maddoxlab/spdif-splitter/README.md

# spdif-splitter
Design files and code for S/Plitter, a box that turns optical S/PDIF signals into separate TTL bits for EEG triggering in auditory experiments
