maddoxlab/spdif-splitter/bp2bs_adapter/adapter/adapter.kicad_pcb

## KiCad design bp2bs_adapter/adapter/adapter.kicad_pcb (2021-09-14)

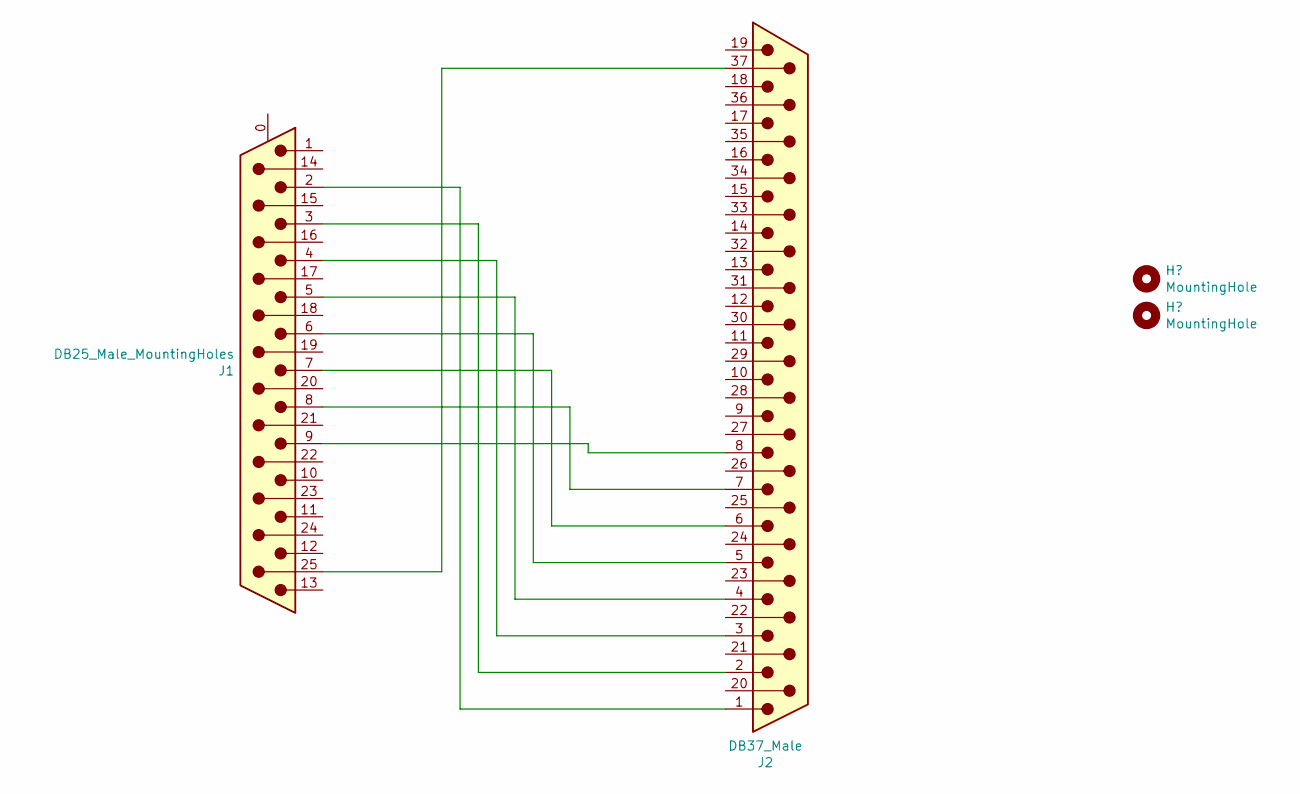
[picture p1: schematic adapter.sch]

Parts:
J1: DB25_Male_MountingHoles; DSUB-25_Male_Horizontal_P2.77x2.84mm_EdgePinOffset4.94mm_Ho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
J2: DB37_Male; DSUB-37_Male_Horizontal_P2.77x2.84mm_EdgePinOffset7.70mm_Ho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

Connections:
unnamed: J1.2, J2.1
unnamed: J1.3, J2.2
unnamed: J1.4, J2.3
unnamed: J1.5, J2.4
unnamed: J1.6, J2.5
unnamed: J1.7, J2.6
unnamed: J1.8, J2.7
unnamed: J1.9, J2.8
unnamed: J1.25, J2.37

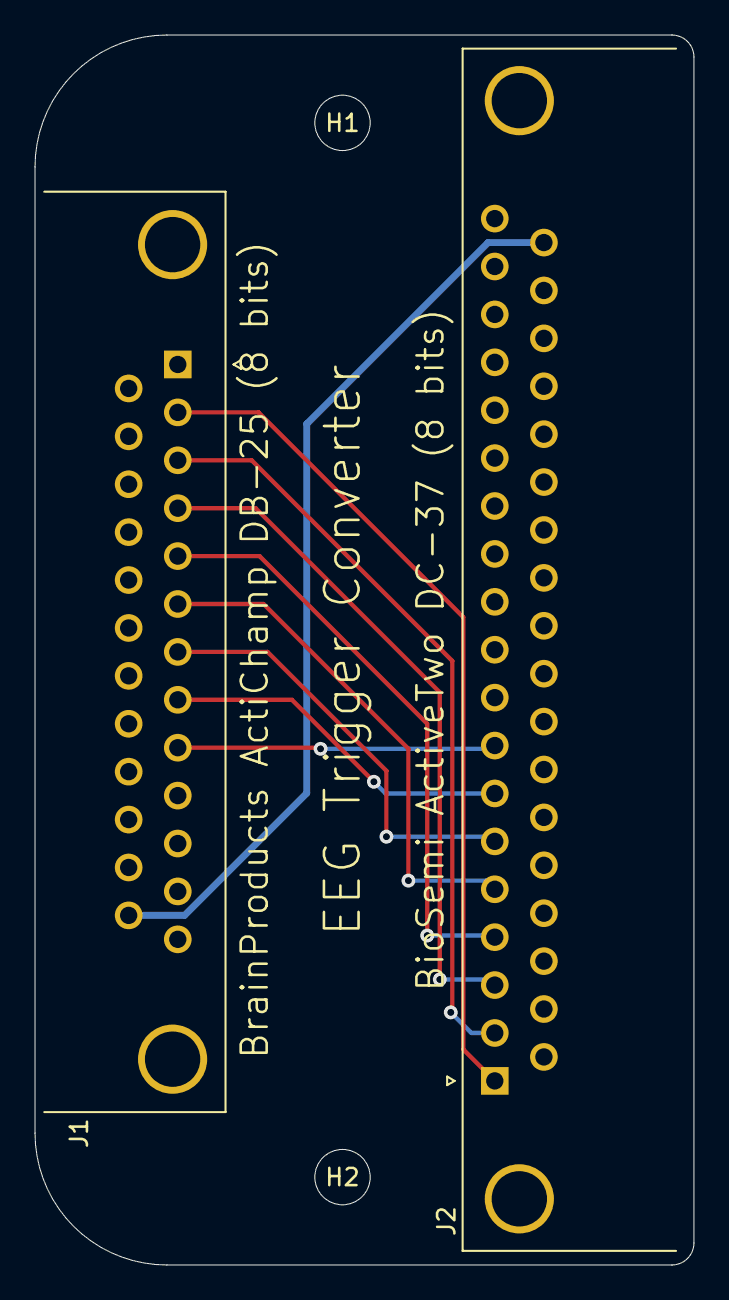
[picture p2: board adapter.kicad_pcb from above]

Board: 2 copper layers, 38.1 x 71.1 mm, 4 parts (0 on the bottom side), 9 nets.

Other parts of the board:
H1, H2: MountingHole; MountingHole_3.2mm_M3
