maddoxlab/spdif-splitter/v2/kicad/spdif-decoder/spdif-decoder.kicad_pcb

## KiCad design v2/kicad/spdif-decoder/spdif-decoder.kicad_pcb (2021-08-18)

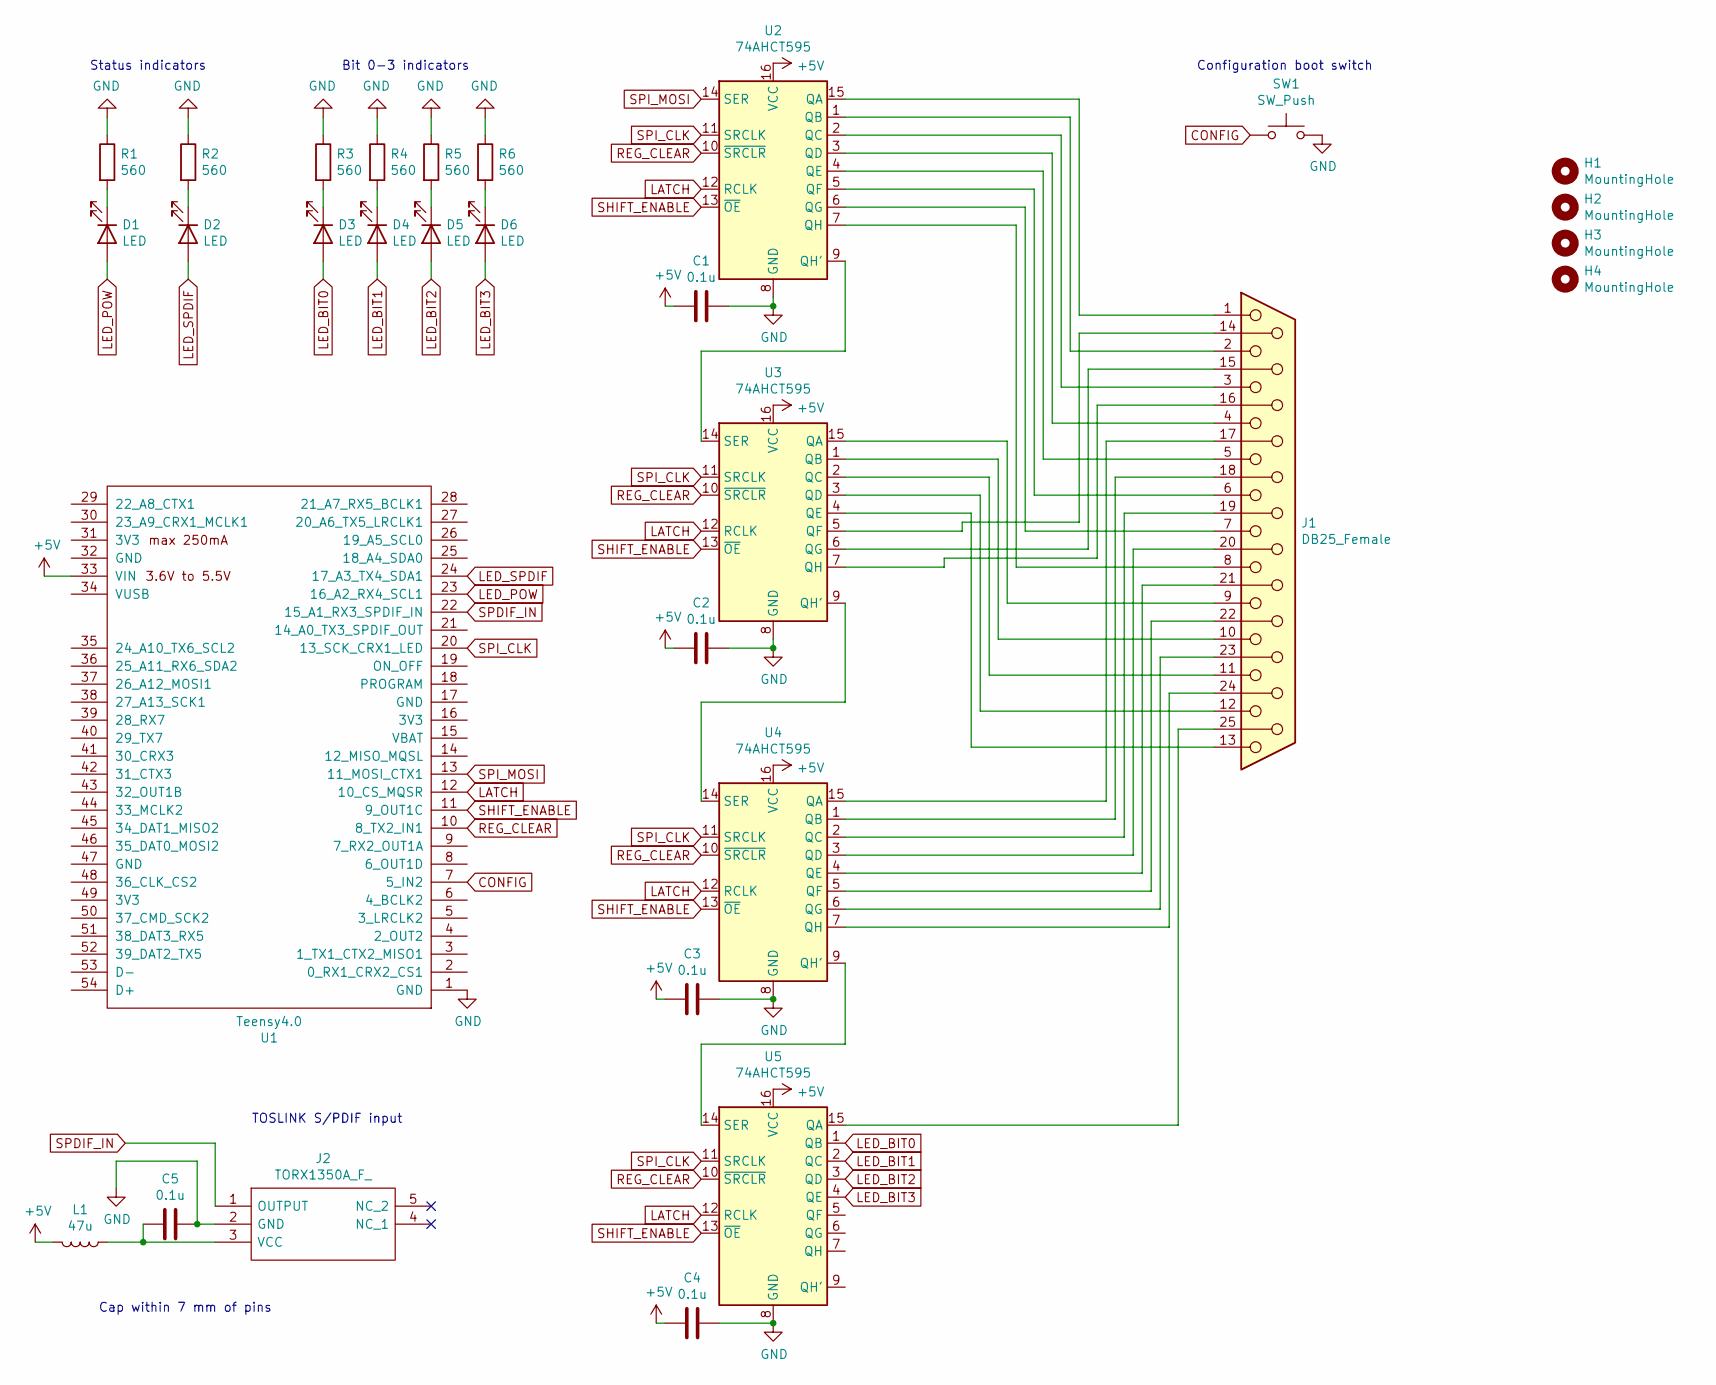
[picture p3: schematic spdif-decoder.sch]

Parts:
C1, C2, C3, C4, C5: 0.1u; C_Disc_D3.0mm_W2.0mm_P2.50mm
D1, D2, D3, D4, D5, D6: LED; LED_D3.0mm
H1, H2, H3, H4: MountingHole; MountingHole_3.2mm_M3
J1: DB25_Female; DSUB-25_Female_Horizontal_P2.77x2.84mm_EdgePinOffset9.90mm_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
J2: TORX1350A_F_; TORX1350AF; Mouser Part Number 757-TORX1350AF
L1: 47u; L_Axial_L5.3mm_D2.2mm_P2.54mm_Vertical_Vishay_IM-1
R1, R2, R3, R4, R5, R6: 560; R_Axial_DIN0207_L6.3mm_D2.5mm_P7.62mm_Horizontal
SW1: SW_Push; SW_PUSH_6mm
U1: Teensy4.0; Teensy40
U2, U3, U4, U5: 74AHCT595; DIP-16_W7.62mm

Connections:
+5V: C1.2, C2.2, C3.2, C4.2, L1.2, U1.33 (VIN), U2.16 (VCC), U3.16 (VCC), U4.16 (VCC), U5.16 (VCC)
CONFIG: SW1.1, U1.7 (5_IN2)
GND: C1.1, C2.1, C3.1, C4.1, C5.1, J2.2 (GND), R1.1, R2.1, R3.1, R4.1, R5.1, R6.1, SW1.2, U1.1 (GND), U2.8 (GND), U3.8 (GND), U4.8 (GND), U5.8 (GND)
LATCH: U1.12 (10_CS_MQSR), U2.12 (RCLK), U3.12 (RCLK), U4.12 (RCLK), U5.12 (RCLK)
LED_BIT0: D3.2 (A), U5.1 (QB)
LED_BIT1: D4.2 (A), U5.2 (QC)
LED_BIT2: D5.2 (A), U5.3 (QD)
LED_BIT3: D6.2 (A), U5.4 (QE)
LED_POW: D1.2 (A), U1.23 (16_A2_RX4_SCL1)
LED_SPDIF: D2.2 (A), U1.24 (17_A3_TX4_SDA1)
unnamed: C5.2, J2.3 (VCC), L1.1
unnamed: D1.1 (K), R1.2
unnamed: D2.1 (K), R2.2
unnamed: D3.1 (K), R3.2
unnamed: D4.1 (K), R4.2
unnamed: D5.1 (K), R5.2
unnamed: D6.1 (K), R6.2
unnamed: J1.1, U2.15 (QA)
unnamed: J1.2, U2.1 (QB)
unnamed: J1.3, U2.2 (QC)
unnamed: J1.4, U2.3 (QD)
unnamed: J1.5, U2.4 (QE)
unnamed: J1.6, U2.5 (QF)
unnamed: J1.7, U2.6 (QG)
unnamed: J1.8, U2.7 (QH)
unnamed: J1.9, U3.15 (QA)
unnamed: J1.10, U3.1 (QB)
unnamed: J1.11, U3.2 (QC)
unnamed: J1.12, U3.3 (QD)
unnamed: J1.13, U3.4 (QE)
unnamed: J1.14, U3.5 (QF)
unnamed: J1.15, U3.6 (QG)
unnamed: J1.16, U3.7 (QH)
unnamed: J1.17, U4.15 (QA)
unnamed: J1.18, U4.1 (QB)
unnamed: J1.19, U4.2 (QC)
unnamed: J1.20, U4.3 (QD)
unnamed: J1.21, U4.4 (QE)
unnamed: J1.22, U4.5 (QF)
unnamed: J1.23, U4.6 (QG)
unnamed: J1.24, U4.7 (QH)
unnamed: J1.25, U5.15 (QA)
unnamed: U2.9 (QH'), U3.14 (SER)
unnamed: U3.9 (QH'), U4.14 (SER)
unnamed: U4.9 (QH'), U5.14 (SER)
REG_CLEAR: U1.10 (8_TX2_IN1), U2.10 (~SRCLR), U3.10 (~SRCLR), U4.10 (~SRCLR), U5.10 (~SRCLR)
SHIFT_ENABLE: U1.11 (9_OUT1C), U2.13 (~OE), U3.13 (~OE), U4.13 (~OE), U5.13 (~OE)
SPDIF_IN: J2.1 (OUTPUT), U1.22 (15_A1_RX3_SPDIF_IN)
SPI_CLK: U1.20 (13_SCK_CRX1_LED), U2.11 (SRCLK), U3.11 (SRCLK), U4.11 (SRCLK), U5.11 (SRCLK)
SPI_MOSI: U1.13 (11_MOSI_CTX1), U2.14 (SER)

Notes on the sheet:
Bit 0-3 indicators
Status indicators
TOSLINK S/PDIF input
Cap within 7 mm of pins
Configuration boot switch

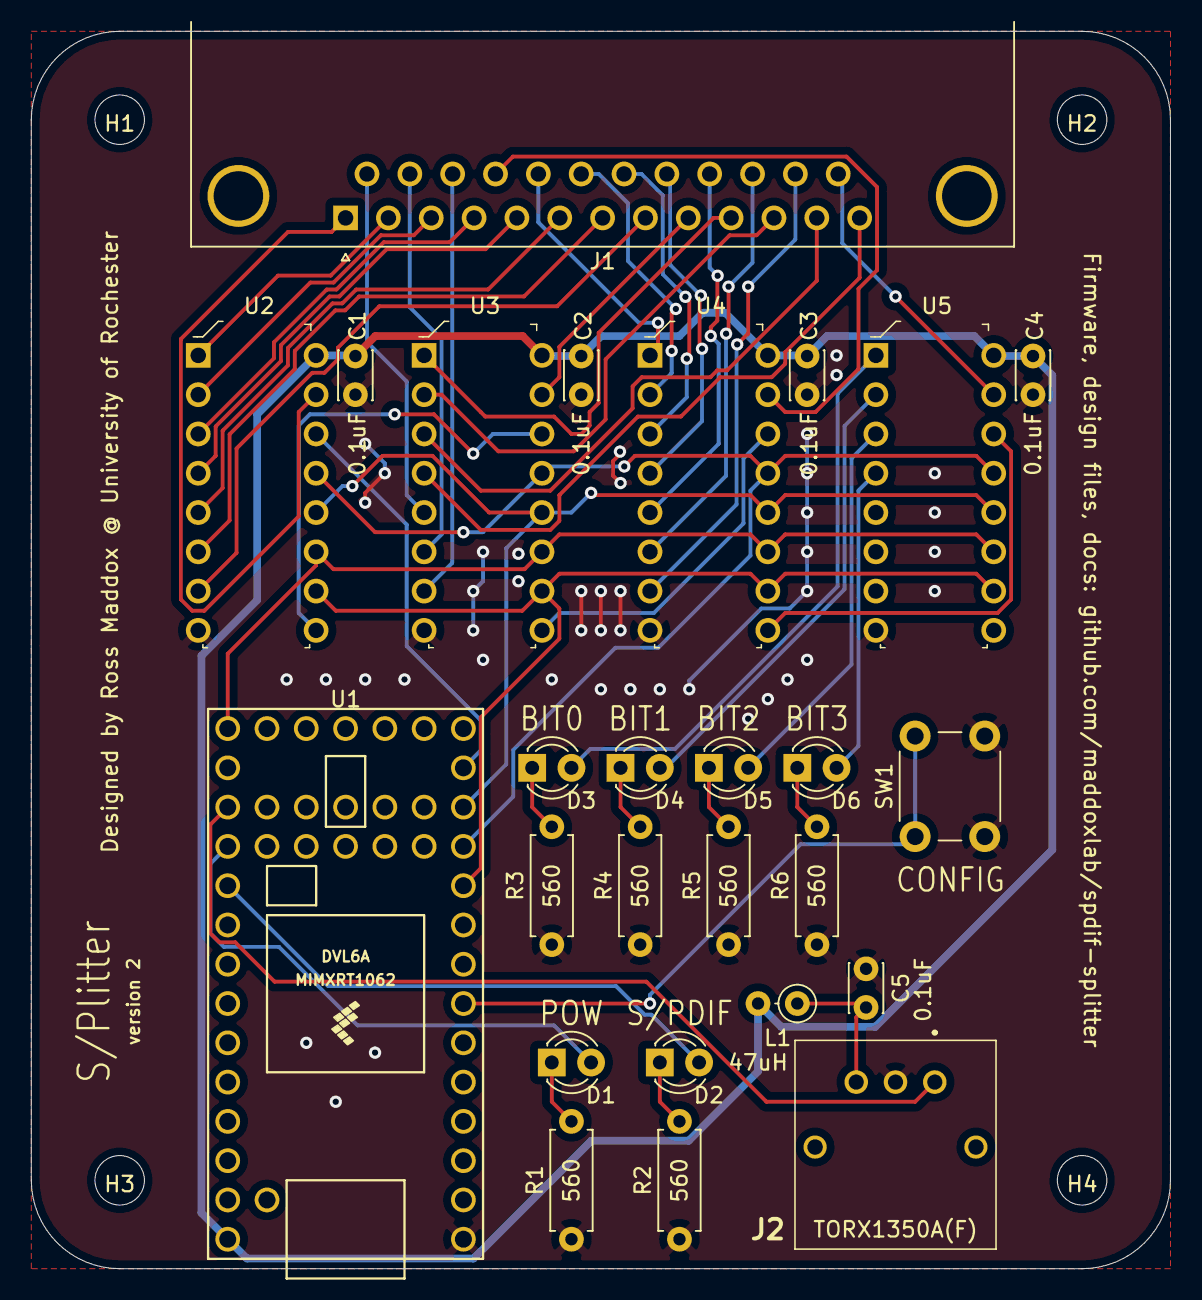
[picture p4: board spdif-decoder.kicad_pcb from above]

Board: 2 copper layers, 73.7 x 80.0 mm, 30 parts (0 on the bottom side), 50 nets.
