maddoxlab/spdif-splitter/(commit log)

2021-08-16 add inital files
    [spdif-decoder-B_Cu.gbr, spdif-decoder-B_Mask.gbr, spdif-decoder-B_Paste.gbr, spdif-decoder-B_SilkS.gbr, spdif-decoder-Edge_Cuts.gbr, spdif-decoder-F_Cu.gbr, spdif-decoder-F_Mask.gbr, spdif-decoder-F_Paste.gbr]
2021-08-18 add v2
    [spdif-decoder-B_Cu.gbr, spdif-decoder-B_Mask.gbr, spdif-decoder-B_Paste.gbr, spdif-decoder-B_SilkS.gbr, spdif-decoder-Edge_Cuts.gbr, spdif-decoder-F_Cu.gbr, spdif-decoder-F_Mask.gbr, spdif-decoder-F_Paste.gbr]
2021-08-18 mods, case
    [spdif-decoder-B_Cu.gbr, spdif-decoder-B_Mask.gbr, spdif-decoder-B_Paste.gbr, spdif-decoder-B_SilkS.gbr, spdif-decoder-Edge_Cuts.gbr, spdif-decoder-F_Cu.gbr, spdif-decoder-F_Mask.gbr, spdif-decoder-F_Paste.gbr]
2023-03-24 Update spdif-splitter.ino
    Fix SPDIF FIFO read in v2
    [spdif-splitter.ino]
2023-03-30 Update spdif-splitter.ino
    Fixed OOO error with parentheses
    [spdif-splitter.ino]
